Curtin-Motorsport-Team/PDM-2017/README.md

# PDM-2017

Tim's awesome Power Distribution Module for 2017.

A Cool Screenshot
