Curtin-Motorsport-Team/PDM-2017/Reviews/PDM-17-Critical Design Review.odt

## PDM-17-Critical Design Review

/Users/Emmet/Projects/PDM-2017/Reviews/

# Mini Schematic

## Net Double Ups

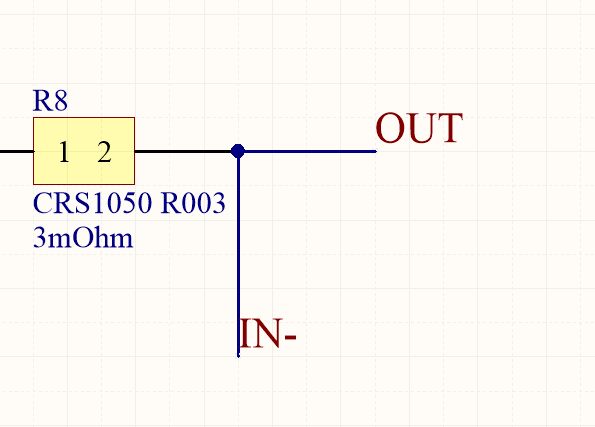
[picture p1: figure]

Altium really doesnt like giving the same net two different names. Here we have either OUT or IN-. It will lead to confusion and sadness if we leave it like this. I have ditched the IN- in favour of just OUT.

## Net Names

I know this is really picky, but if we can its awesome to have super well defined/descriptive net names. IN+ and OUT are a tad bit off, next time something like CURRENT_SIG-, HIGH_POWER_OUT might be a good idea

## Bus Sense Resistors

Changing the values of these guys to, 1.6k Top and 390 Bottom. To give a maximum reading of 16.8 V with a resolution of 4 mV. In Purchasing they need to be a lot temp drift, but not overly accurate, we can calibrate them out easy enough!

It would be awesome to add in a smoothing capacitor to the output of them as this will help in the PWMming of the signal. Ive put in 0.1 uF but it might be good, it might be bad I dunno!

## Opto Powering

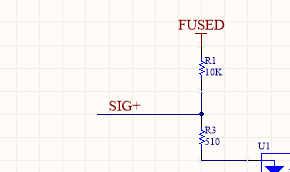
[picture p2: figure]

Sorry, I just came up with this topology, I think it allows for a nicer, less noisier setup. But essentially we are just splitting the grounds up, rather than using the high current GND we are just going to drop a ground in from the top to power the opto.

Also R1, the 10k pullup to FUSED is a REALLY BAD idea. It was in the old PDM designs in order to be an optionally placed device, if it is placed in this we WILL destroy the micro as it has the potential to raise the 3.3 V bus to the full FUSED rail.

Ill also rename some nets to be a tad bit clearer.

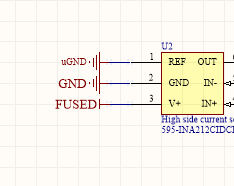
[picture p3: figure]

## Changed INA’s Reference

Given the topology of the grounds are changning then we have this somewhat nicer ground to use, so we shall use it!

## Custom Connectors

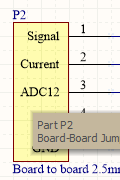
[picture p4: figure]

Use these guys sparingly, use the generic ones with the numbered pins instead and then change the net names, its quicker and easily recyclable. Otherwise you end up having to make a million components and it turns sad face quickly! :(

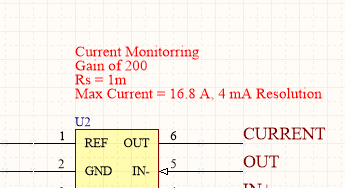
[picture p5: figure]

## Notes on Schematics

This is really helpful:

They show the next bloke what you were thinking when you makeded this. Rough calcs useful, they show what you were aiming for and can be verified later on!

# Mini PCB

## DRC

Well done! Only 60 odd! (Like thats actually totally acceptable!) and theyre all just dopey ones!

Thomas Paynter – PDM-17-Critical Design Review 2017-08-15
