Curtin-Motorsport-Team/PDM-2017/PDM-MAIN/SN65HVD233-EP/SN65HVD233-EP.STEP

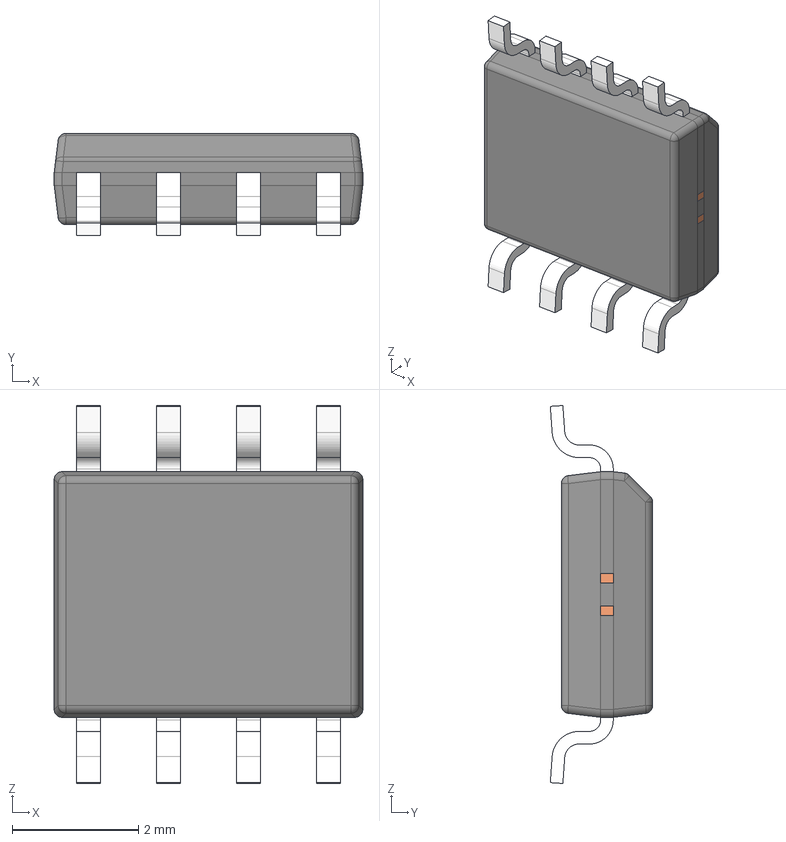
[picture p6: CAD file, 2017-04-29]
PDM-MAIN/SN65HVD233-EP/SN65HVD233-EP.STEP
4.90 x 1.62 x 6.00 mm
BODY_M08A_35
LEAD_M08A_57 x 8
MANIFOLD_SOLID_BREP_2784
MANIFOLD_SOLID_BREP_2935
MANIFOLD_SOLID_BREP_3086
MANIFOLD_SOLID_BREP_3237
