Curtin-Motorsport-Team/PDM-2017/PDM-MAIN/User Library-STM32F107 -LQFP64 10mm x 10mm/User Library-STM32F107 -LQFP64 10mm x 10mm.SLDPRT

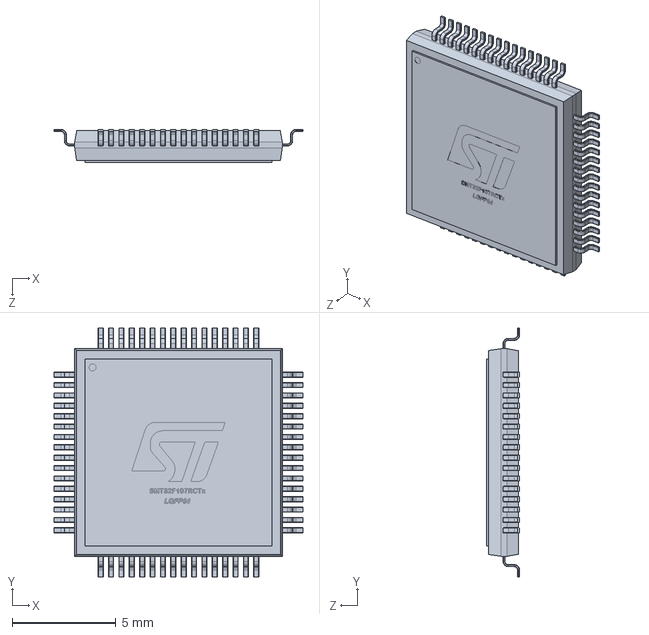
[picture p7: CAD file, 2017-04-29]
PDM-MAIN/User Library-STM32F107 -LQFP64 10mm x 10mm/User Library-STM32F107 -LQFP64 10mm x 10mm.SLDPRT
12.0 x 12.0 x 1.59 mm
