Curtin-Motorsport-Team/PDM-2017/PDM-MAIN/PDM Mk21.pdf

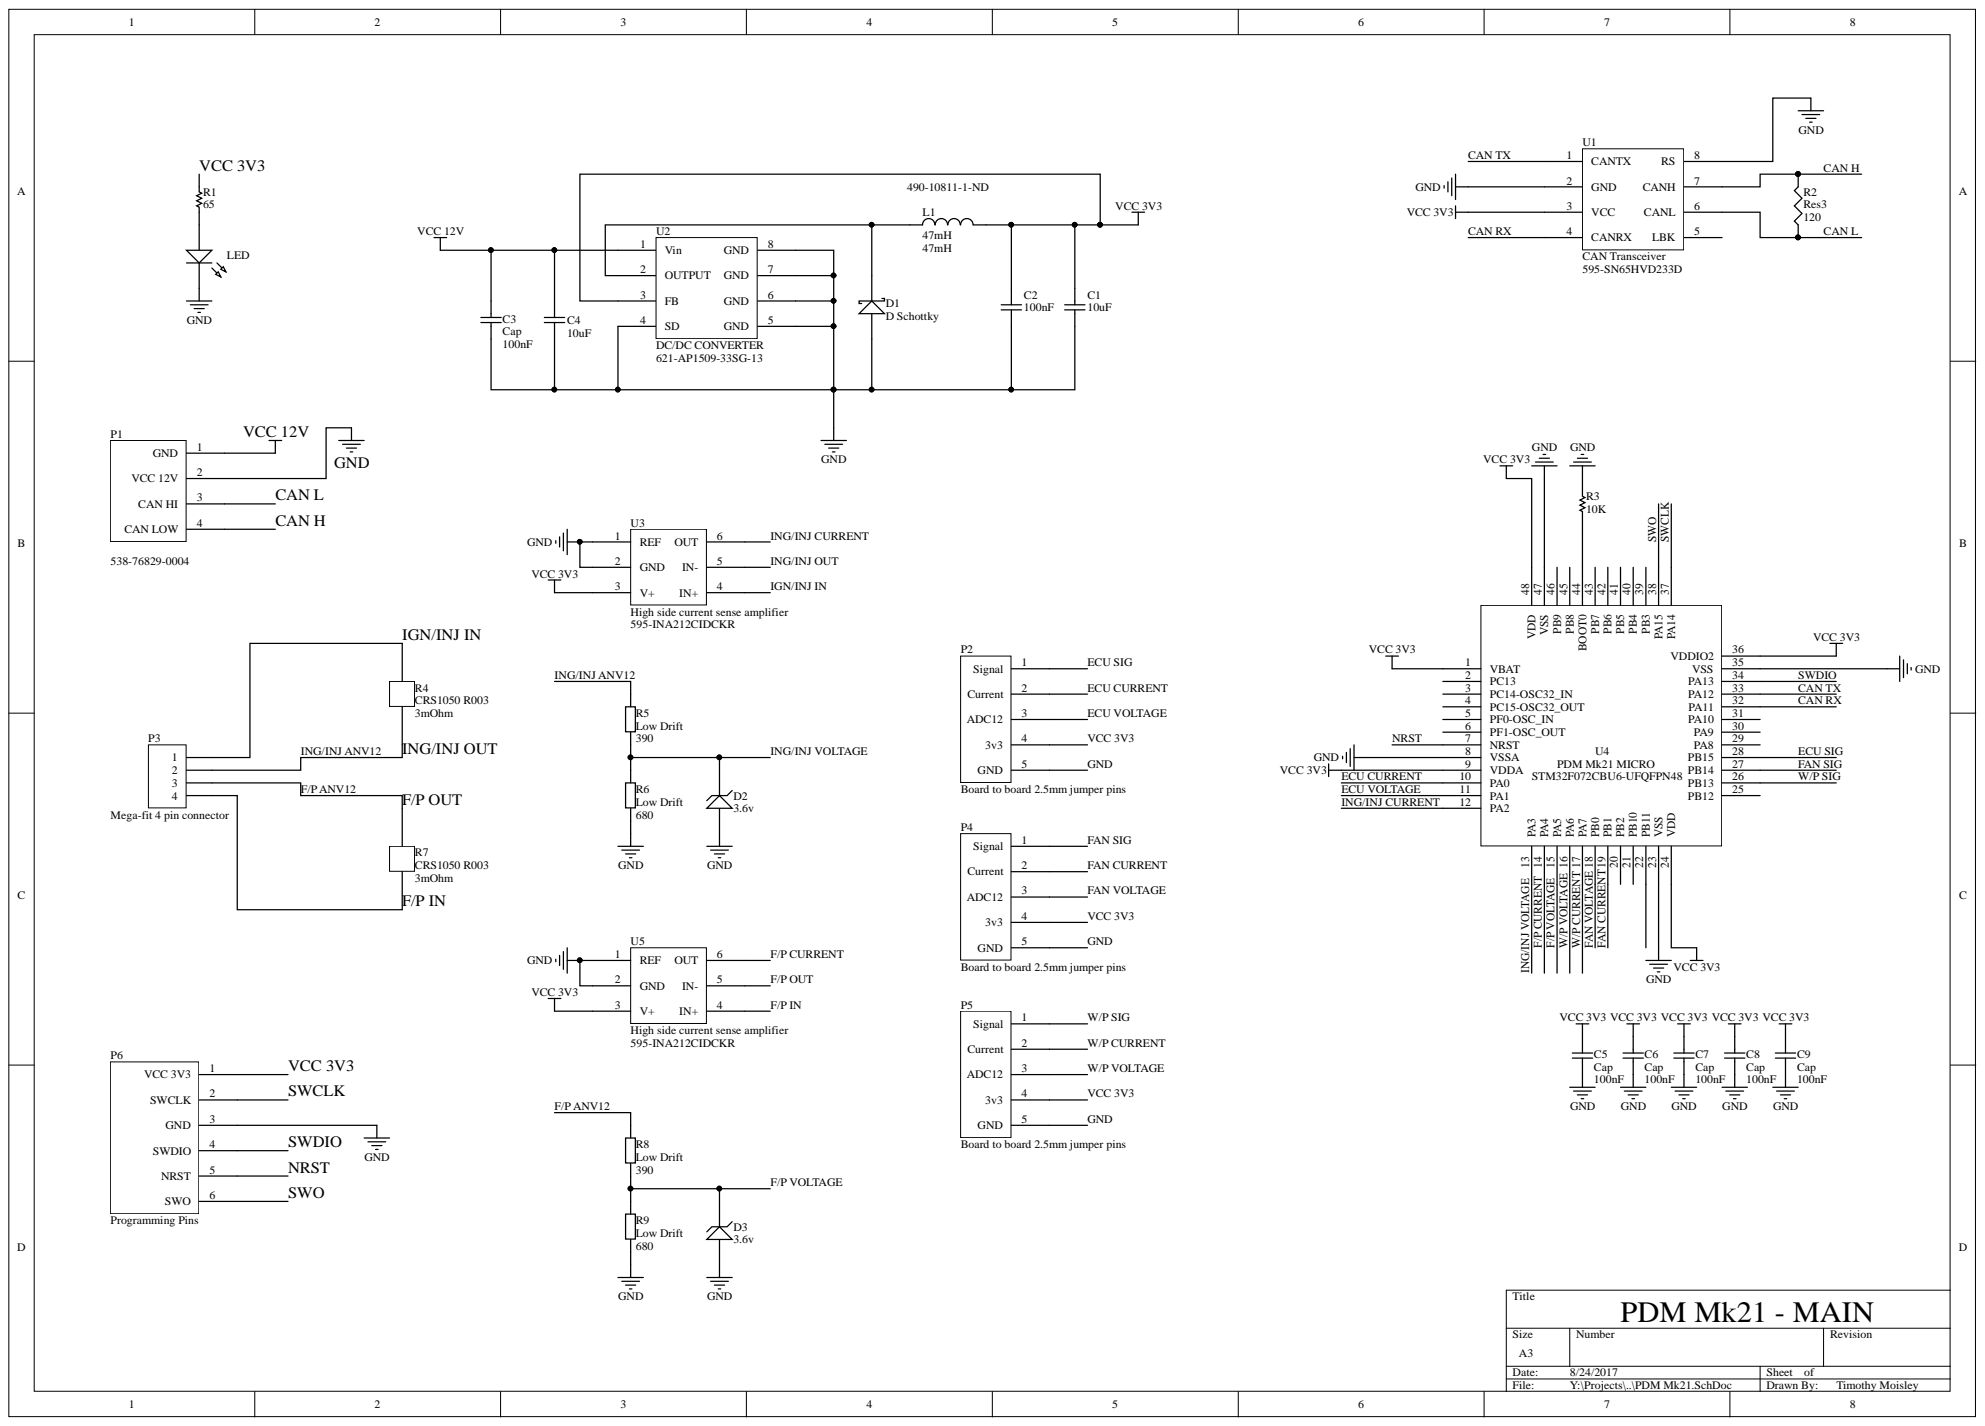
[picture p8: page 1]

ECU SIG FAN SIG
