Curtin-Motorsport-Team/PDM-2017/PDM-MINI/PDM Mk21 - Mini.pdf

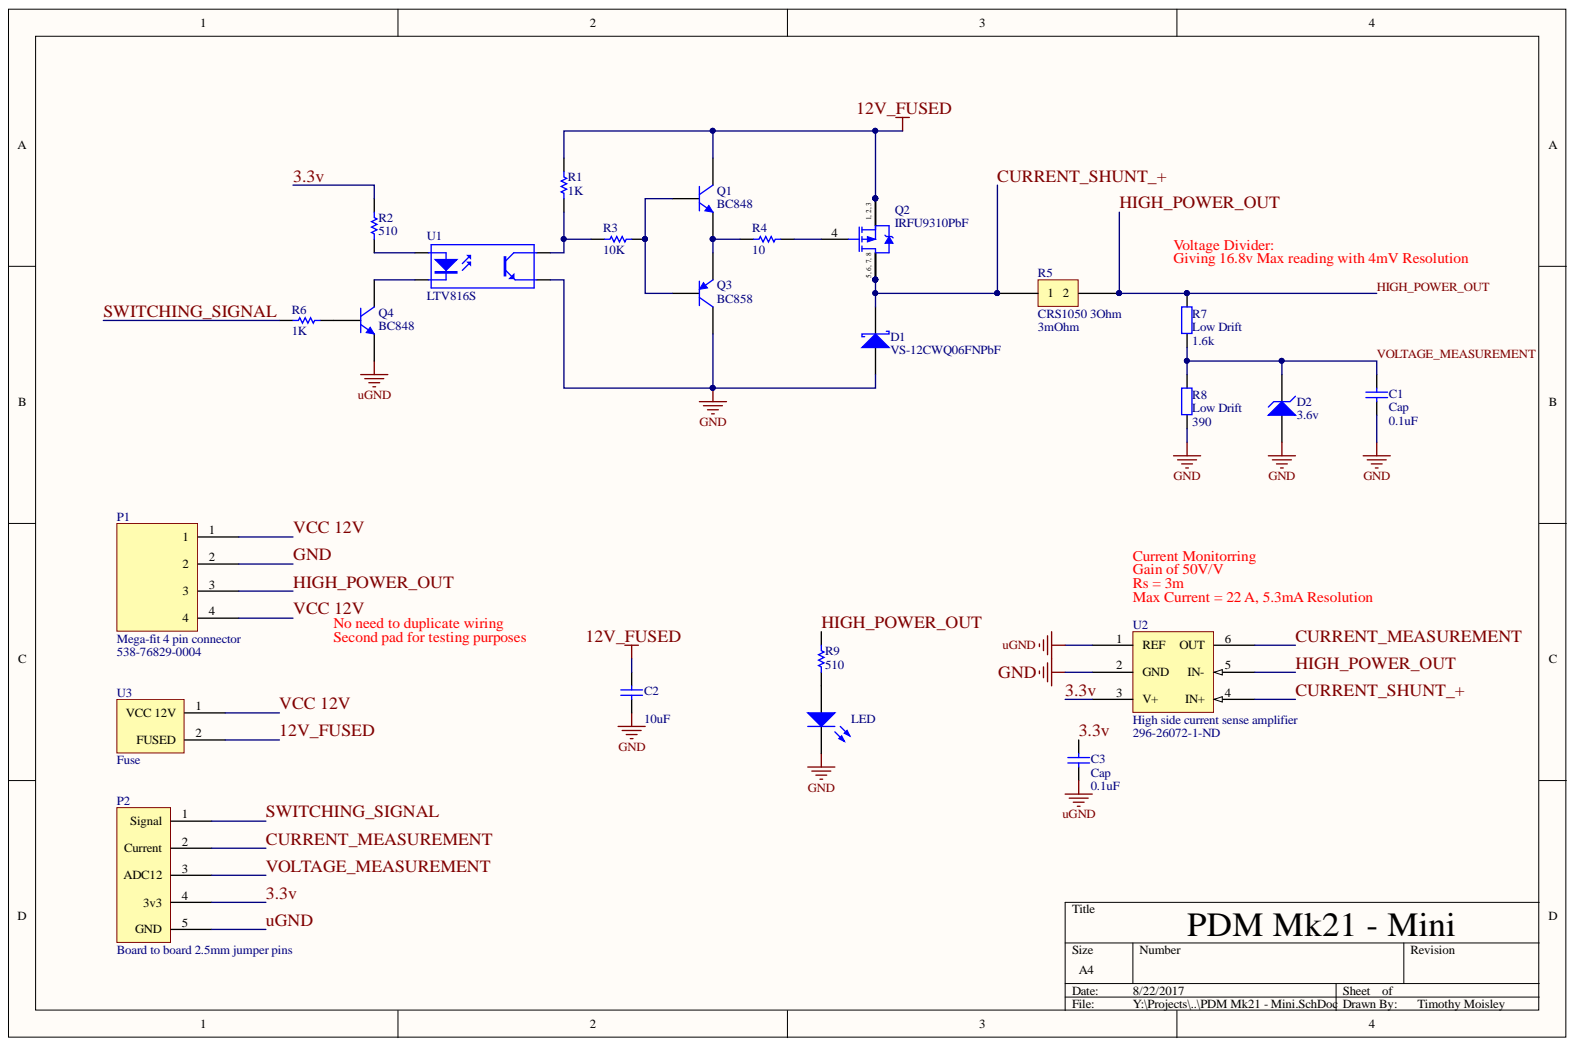
[picture p9: page 1]

Giving 16.8v Max reading with 4mV Resolution Voltage Divider:

Current Monitorring
Gain of 50V/V
Rs = 3m Max Current = 22 A, 5.3mA Resolution

No need to duplicate wiring

Mega-fit 4 pin connector

High side current sense amplifier

Board to board 2.5mm jumper pins

Size A4 | Number | Revision

Date: 8/22/2017 | Sheet of
File: Y:\Projects\..\PDM Mk21 - Mini.SchDoc | Drawn By: Timothy Moisley
