Curtin-Motorsport-Team/PDM-2017/(list of files, drawings)

Other design files:
Manufacture_Panel.PcbDoc
PDM-MAIN/PDM Mk21.PcbDoc
PDM-MAIN/PDM Mk21.PcbLib
PDM-MAIN/PDM Mk21.PrjPcb
PDM-MAIN/PDM Mk21.SchDoc
PDM-MAIN/PDM Mk21.SchLib
PDM-MINI/PDM Mk21 - Mini.PcbLib
PDM-MINI/PDM Mk21 - Mini.PrjPCB
PDM-MINI/PDM Mk21 - Mini.SchDoc
PDM-MINI/PDM Mk21 - Mini.SchLib
PDM-MINI/PDM Mk 21 - Mini1/PDM Mk 21 - Mini.PcbLib
PDM-MINI/PDM Mk 21 - Mini1/PDM Mk 21 - Mini_1.SCHLIB
PDM-MINI/PDM Mk 21 - Mini.PcbDoc
