Curtin-Motorsport-Team/PDM-2017/(threads)

Thread 1 (2017-05-04):

Pretty Picture

Michael-F-Bryan, 2017-05-04:
If you send me a picture of the PDM board so far we can add it to the project's front page. Reckon it's worth it?

timothymoisley, 2017-05-17:
Hey,

Sorry its a bit late (didn’t actually finish the altium files) until today

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

Michael-F-Bryan, 2017-05-17:
Want to drop a screenshot in this issue so I can add it to your front page like I did with Tom's [CarLogs] repo?

[CarLogs]: https://github.com/Curtin-Motorsport-Team/CarLogs

timothymoisley, 2017-05-18:
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

Closed 2017-05-18.
