Curtin-Motorsport-Team/PDM-2017/Software/PDM-Cube.ioc

Mcu.UserName=STM32F072CBUx
PA0.GPIO_Label=ADC_IN0_ECU-CURRENT
PA0.Signal=ADC_IN0
PA1.GPIO_Label=ADC_IN1_ECU-VOLTAGE
PA1.Signal=ADC_IN1
PA11.Signal=CAN_RX
PA12.Signal=CAN_TX
PA13.Signal=SYS_SWDIO
PA14.Signal=SYS_SWCLK
PA2.GPIO_Label=ADC_IN2_INJIGN-CURRENT
PA2.Signal=ADC_IN2
PA3.GPIO_Label=ADC_IN3_INJIGN-VOLTAGE
PA3.Signal=ADC_IN3
PA4.GPIO_Label=ADC_IN4_FP-CURRENT
PA4.Signal=ADC_IN4
PA5.GPIO_Label=ADC_IN5_FP-VOLTAGE
PA5.Signal=ADC_IN5
PA6.GPIO_Label=ADC_IN6_WP-VOLTAGE
PA6.Signal=ADC_IN6
PA7.GPIO_Label=ADC_IN7_WP-CURRENT
PA7.Signal=ADC_IN7
PB0.GPIO_Label=ADC_IN8_FAN-VOLTAGE
PB0.Signal=ADC_IN8
PB1.GPIO_Label=ADC_IN9_FAN-CURRENT
PB1.Signal=ADC_IN9
PB13.GPIO_Label=TIM1_CH1N_WP-SIG
PB13.Signal=TIM1_CH1N
PB14.GPIO_Label=TIM1_CH2N_FAN-SIG
PB14.Signal=TIM1_CH2N
PB15.GPIO_Label=TIM1_CH3N_ECU-SIG
PB15.Signal=TIM1_CH3N
PB6.Signal=USART1_TX
PB7.Signal=USART1_RX
