Curtin-Motorsport-Team/PDM-2017/(commit log)

2017-04-29 Moved PDM to GitHub
    [PDM Mk 21 - Mini.PcbDoc, PDM Mk21 - Mini.PcbLib, PDM Mk21 - Mini.PrjPCB, PDM Mk21 - Mini.SchDoc, PDM Mk21 - Mini.SchLib, PDM Mk21.PcbLib, PDM Mk21.PrjPcb, PDM Mk21.SchDoc]
2017-04-29 Current Measurement Added
    [PDM Mk 21 - Mini.PcbDoc, PDM Mk 21 - Mini.PcbLib, PDM Mk 21 - Mini_1.SCHLIB, PDM Mk21 - Mini.PcbLib, PDM Mk21 - Mini.PrjPCB, PDM Mk21 - Mini.SchDoc, PDM Mk21 - Mini.SchLib, PDM Mk21.PcbLib]
2017-05-05 Mini PDM board "finished"
    Probs not fully finished
    [PDM Mk 21 - Mini.PcbDoc, PDM Mk21 - Mini.PcbLib, PDM Mk21 - Mini.SchDoc, PDM Mk21 - Mini.SchLib, PDM Mk21.SchDoc]
2017-05-12 PDM Mk 21-main added
    Added almost complete PDM MK 21-main PCB
    [PDM Mk 21 - Mini.PcbDoc, PDM Mk21.PcbDoc, PDM Mk21.PcbLib, PDM Mk21.PrjPcb, PDM Mk21.SchDoc, PDM Mk21.SchLib]
2017-05-14 PDM Mk21-main "finished"
    [PDM Mk21.PcbDoc, PDM Mk21.SchDoc]
2017-05-15 Changed programming pins
    Changed to 6 programming pins on Main PDM
    [PDM Mk 21 - Mini.step, PDM Mk21.PcbDoc, PDM Mk21.PcbLib, PDM Mk21.SchDoc, PDM Mk21.SchLib]
2017-05-17 Changed LED position
    [PDM Mk 21 - Mini.PcbDoc, PDM Mk21 - Mini.PrjPCB, PDM Mk21.PcbDoc, PDM Mk21.PrjPcb]
2017-05-28 Added datasheets
    [PDM Mk21 - Mini.PrjPCB, PDM Mk21 - Mini.SchDoc, PDM Mk21.PrjPcb]
2017-06-05 Added Voltage Measurement
    Added Voltage measurement to both MINI & MAIN PDMs, added additional board to board connections and chnaged connectors for PDM MAIN
    [PDM Mk 21 - Mini.PcbDoc, PDM Mk 21 - Mini.PcbLib, PDM Mk 21 - Mini_1.SCHLIB, PDM Mk21 - Mini.PcbLib, PDM Mk21 - Mini.PrjPCB, PDM Mk21 - Mini.SchDoc, PDM Mk21 - Mini.SchLib, PDM Mk21.PcbDoc]
2017-07-11 Made PDM smaller
    Made PDM significantly smaller, added via stiching and changed the MOLEX connectors to horizontal mounting
    [PDM Mk 21 - Mini.PcbDoc, PDM Mk21 - Mini.PcbLib, PDM Mk21 - Mini.PrjPCB, PDM Mk21 - Mini.SchDoc, PDM Mk21 - Mini.SchLib, PDM Mk21.PcbDoc, PDM Mk21.PcbLib, PDM Mk21.PrjPcb]
2017-07-27 ADDED A MEME!!!
    Fixed a bunch of stuff and ADDED A MEME!!!
    [PDM Mk 21 - Mini.PcbDoc, PDM Mk21 - Mini.SchDoc, PDM Mk21.PcbDoc, PDM Mk21.PcbLib, PDM Mk21.SchDoc]
2017-08-15 It's the final countdown
    [PDM Mk 21 - Mini.PcbDoc, PDM Mk 21 - Mini.step, PDM Mk21.PcbDoc]
2017-08-15 Tom Review, Fix up Mini PCB
    [PDM Mk 21 - Mini.PcbDoc, PDM Mk21 - Mini.SchDoc, PDM Mk21.SchDoc]
2017-08-17 Made review changes to mini PCB
    Made the review changes to the mini PDM PCB
    [PDM Mk 21 - Mini.PcbDoc, PDM Mk21 - Mini.SchDoc]
2017-08-22 Fixed Optoisolator footprint
    [PDM Mk 21 - Mini.PcbDoc, PDM Mk21 - Mini.PcbLib, PDM Mk21 - Mini.SchDoc, PDM Mk21.SchDoc]
2017-08-28 Added Capacitors
    Added capacitors for the current amplifiers on PDM Main
    [PDM Mk21.PcbDoc, PDM Mk21.PrjPcb, PDM Mk21.SchDoc]
